asmith326/RoboGoose/README.md

# RoboGoose

## Basic Information and Documentation

This project was designed as part of CSE 450/453 at the University at Buffalo, a 2 semester senior design class(es) meant to simulate what working on a project for a real client is like.

The motivation behind this project was to create something to showcase the Computer Engineering BS program to incoming students.

We settled on a goose as they are infamous among the University at Buffalo campus.

Arduiuno Mega code is contained within 'Arduino Mega main.cpp'
The .ino files contain the code for each Arduino Nano ESP32 respectively

Full design documentation can be found [here](https://drive.google.com/file/d/1a4U_esqxt6miaWA_FRZ7XE4XjwnYuKd0/view?usp=sharing)

---------------
---------------
---------------

### Additional Information and Credit

Original team organization [here](https://github.com/cse-450-ROBO-GOOSE)

Code for Arduino Mega and Arduino Nano ESP32 for Bluepad32 are [here](https://github.com/cse-450-ROBO-GOOSE/CanControl-fork)

Code for Arduino Nano ESP32 hosting webserver can be found [here](https://github.com/cse-450-ROBO-GOOSE/goose_soundboard)

---------------

Final code developed by Nicholas Medina and Austin Smith

Additional credit to:
Amie Sallah,
Annie Slenker,
Samuel Tiso,
Thien Phuc Le,
Ahmed Chowdhury,
Eric Butcher,
Samuel Magaseyev
