asmith326/RoboGoose/(commit log)

2026-07-20 Uploaded all 3 arduino files
2026-07-20 Rename main.cpp to Arduino Mega main.cpp
2026-07-20 Update README with Arduino code file details
    Added information about Arduino Mega and Nano ESP32 code files.
